oaklandrobotics/electrical_ora24/StackLight/Circuit_Diagram/IMG_8410.jpg

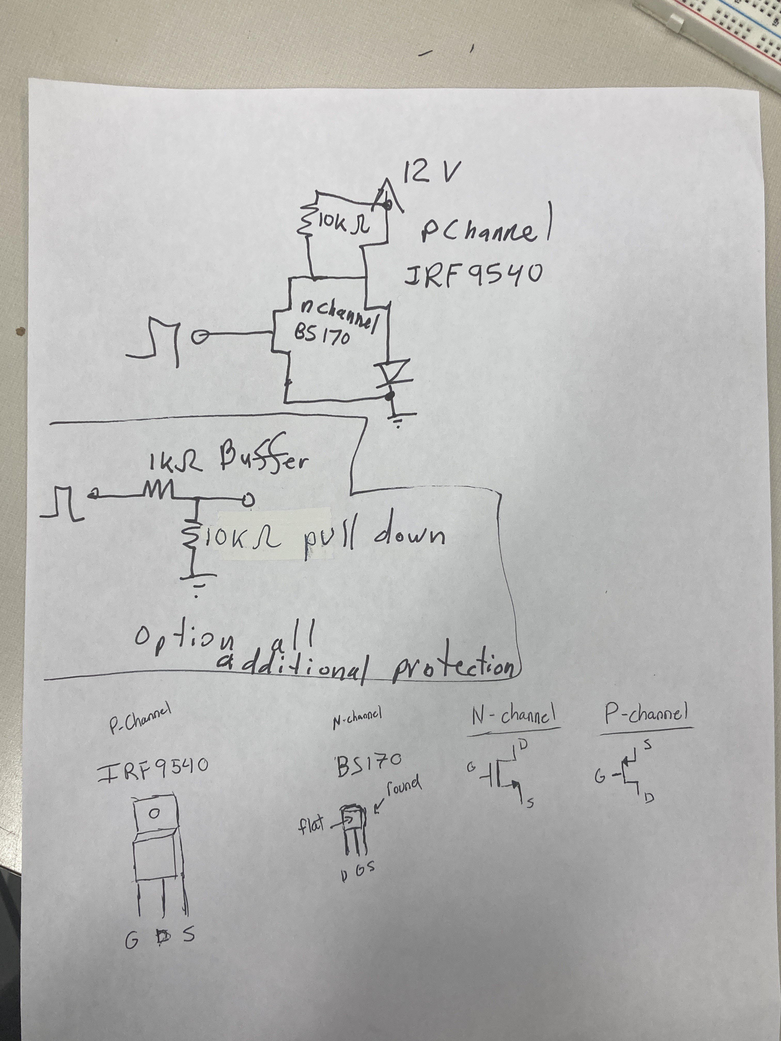
StackLight/Circuit_Diagram/IMG_8410.jpg
