oaklandrobotics/electrical_ora24/ORA_ControlBoard/ORA_ControlBoard-main_Rev_1/README.md

# ORA_ControlBoard
 Control Board for 23/24" IGVC Robot
