oaklandrobotics/electrical_ora24/ORA_ControlBoard/Original Control Board Files/ORA_Control_Board_Rev_2.1/AdditionalParts/SM04B-GHS-TB(LF)(SN)---3DModel-STEP-56544.STEP

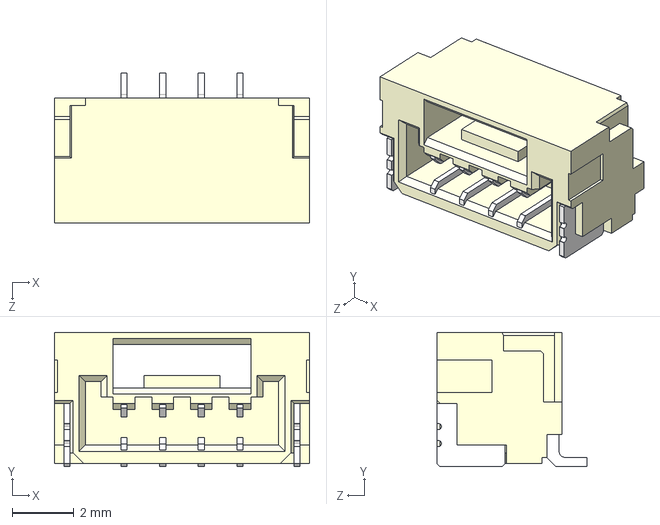
[picture p2: CAD file, 2024-03-11]
ORA_ControlBoard/Original Control Board Files/ORA_Control_Board_Rev_2.1/AdditionalParts/SM04B-GHS-TB(LF)(SN)---3DModel-STEP-56544.STEP
8.25 x 4.35 x 4.85 mm
