oaklandrobotics/electrical_ora24/ORA_ControlBoard/Original Control Board Files/ORA_Control_Board_Rev_2.1/AdditionalParts/SM04B_GHS_TB/SM04B-GHS-TB.STEP

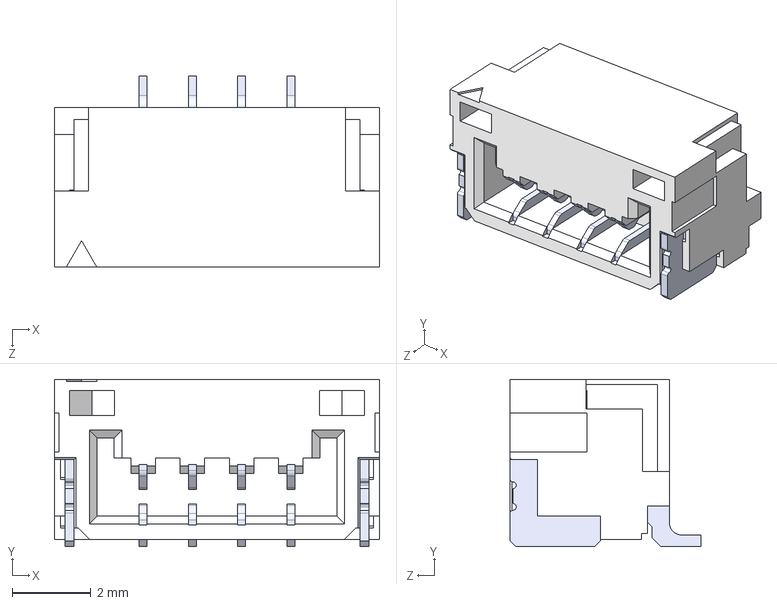
[picture p3: CAD file, 2024-03-09]
ORA_ControlBoard/Original Control Board Files/ORA_Control_Board_Rev_2.1/AdditionalParts/SM04B_GHS_TB/SM04B-GHS-TB.STEP
8.25 x 4.25 x 4.85 mm
SMxB-GHS-TB_04
pin x 4
