oaklandrobotics/electrical_ora24/StackLight/Tests/StackLight/StackLight.step

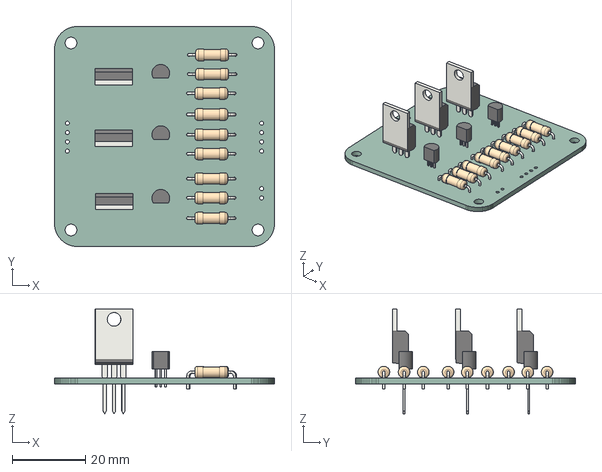
[picture p4: CAD file, 2023-11-30]
StackLight/Tests/StackLight/StackLight.step
60.0 x 60.0 x 28.5 mm
StackLight PCB
