oaklandrobotics/electrical_ora24/ORA_ControlBoard/Original Control Board Files/ORA_Control_Board_Rev_2.1/AdditionalParts/FUSE_F050-2.step

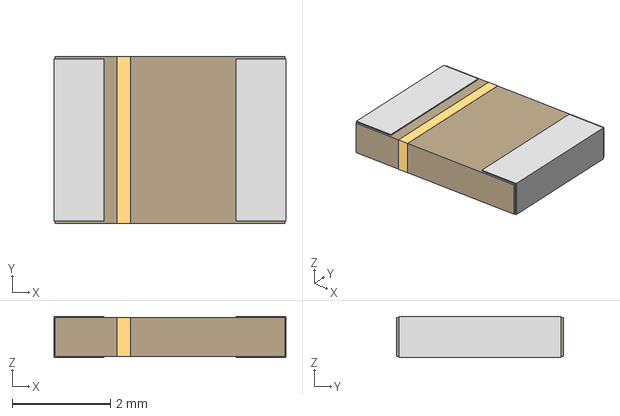
[picture p5: CAD file, 2024-03-11]
ORA_ControlBoard/Original Control Board Files/ORA_Control_Board_Rev_2.1/AdditionalParts/FUSE_F050-2.step
4.72 x 3.41 x 0.838 mm
