oaklandrobotics/electrical_ora24/ORA_ControlBoard/Original Control Board Files/ORA_Control_Board_Rev_2.1/AdditionalParts/CAP_WCAP-ASLI_05p0X05p5_WRE.step

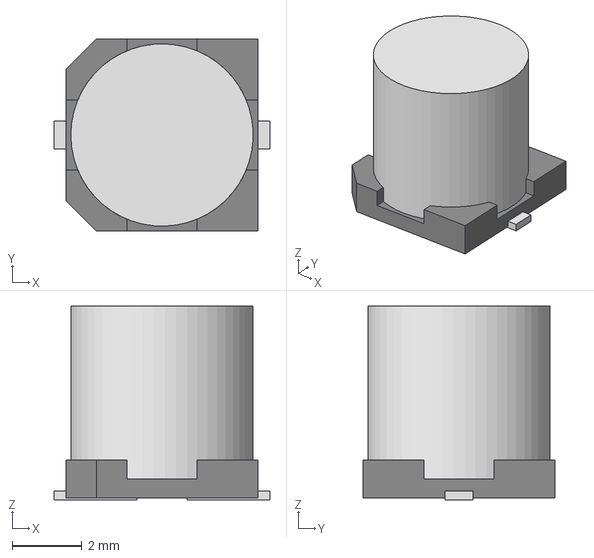
[picture p6: CAD file, 2024-03-11]
ORA_ControlBoard/Original Control Board Files/ORA_Control_Board_Rev_2.1/AdditionalParts/CAP_WCAP-ASLI_05p0X05p5_WRE.step
6.20 x 5.51 x 5.57 mm
