oaklandrobotics/electrical_ora24/ORA_ControlBoard/Original Control Board Files/ORA_Control_Board_Rev_2.1/AdditionalParts/10118192_0002LF (1)/10118192-0002LF.step

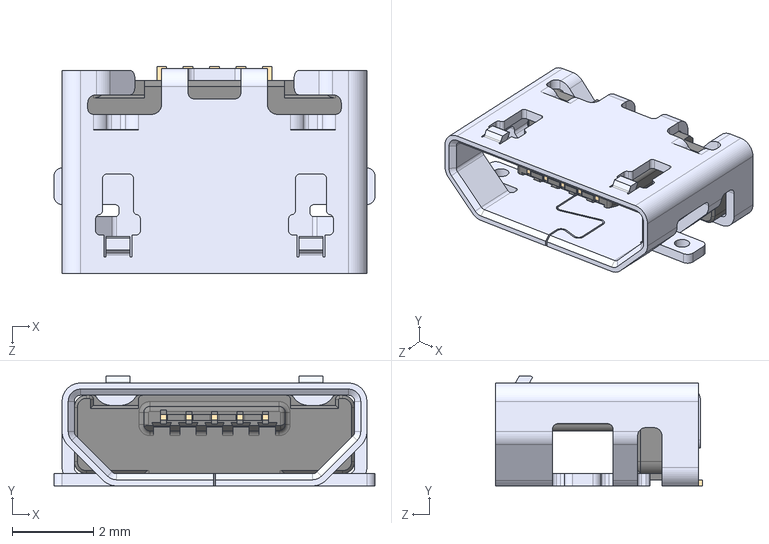
[picture p7: CAD file, 2024-03-11]
ORA_ControlBoard/Original Control Board Files/ORA_Control_Board_Rev_2.1/AdditionalParts/10118192_0002LF (1)/10118192-0002LF.step
7.90 x 2.70 x 5.10 mm
