oaklandrobotics/electrical_ora24/(threads)

Thread 2 (2023-09-26):

Fix Hindsight for possible showcase

AndrewMcGhee, 2023-09-26:
Try to fix Hindsight for the possible showcase in November. Does not need auton, just manual driver + state switching

Thread 6 (2024-05-25):

IGVC Preperations

gtrupiano, 2024-05-25:
- [ ] Add can messages for sending wheel speeds and autonomous state
- [ ] Hardware E-Stop
- [ ] Check controller disconnect fail save
- [ ] Look over Falling Edge Detection
