oaklandrobotics/electrical_ora24/ORA_ControlBoard/Original Control Board Files/ORA_Control_Board_Rev_2.1/ORA Control Board Rev2 2-18-24.pdf

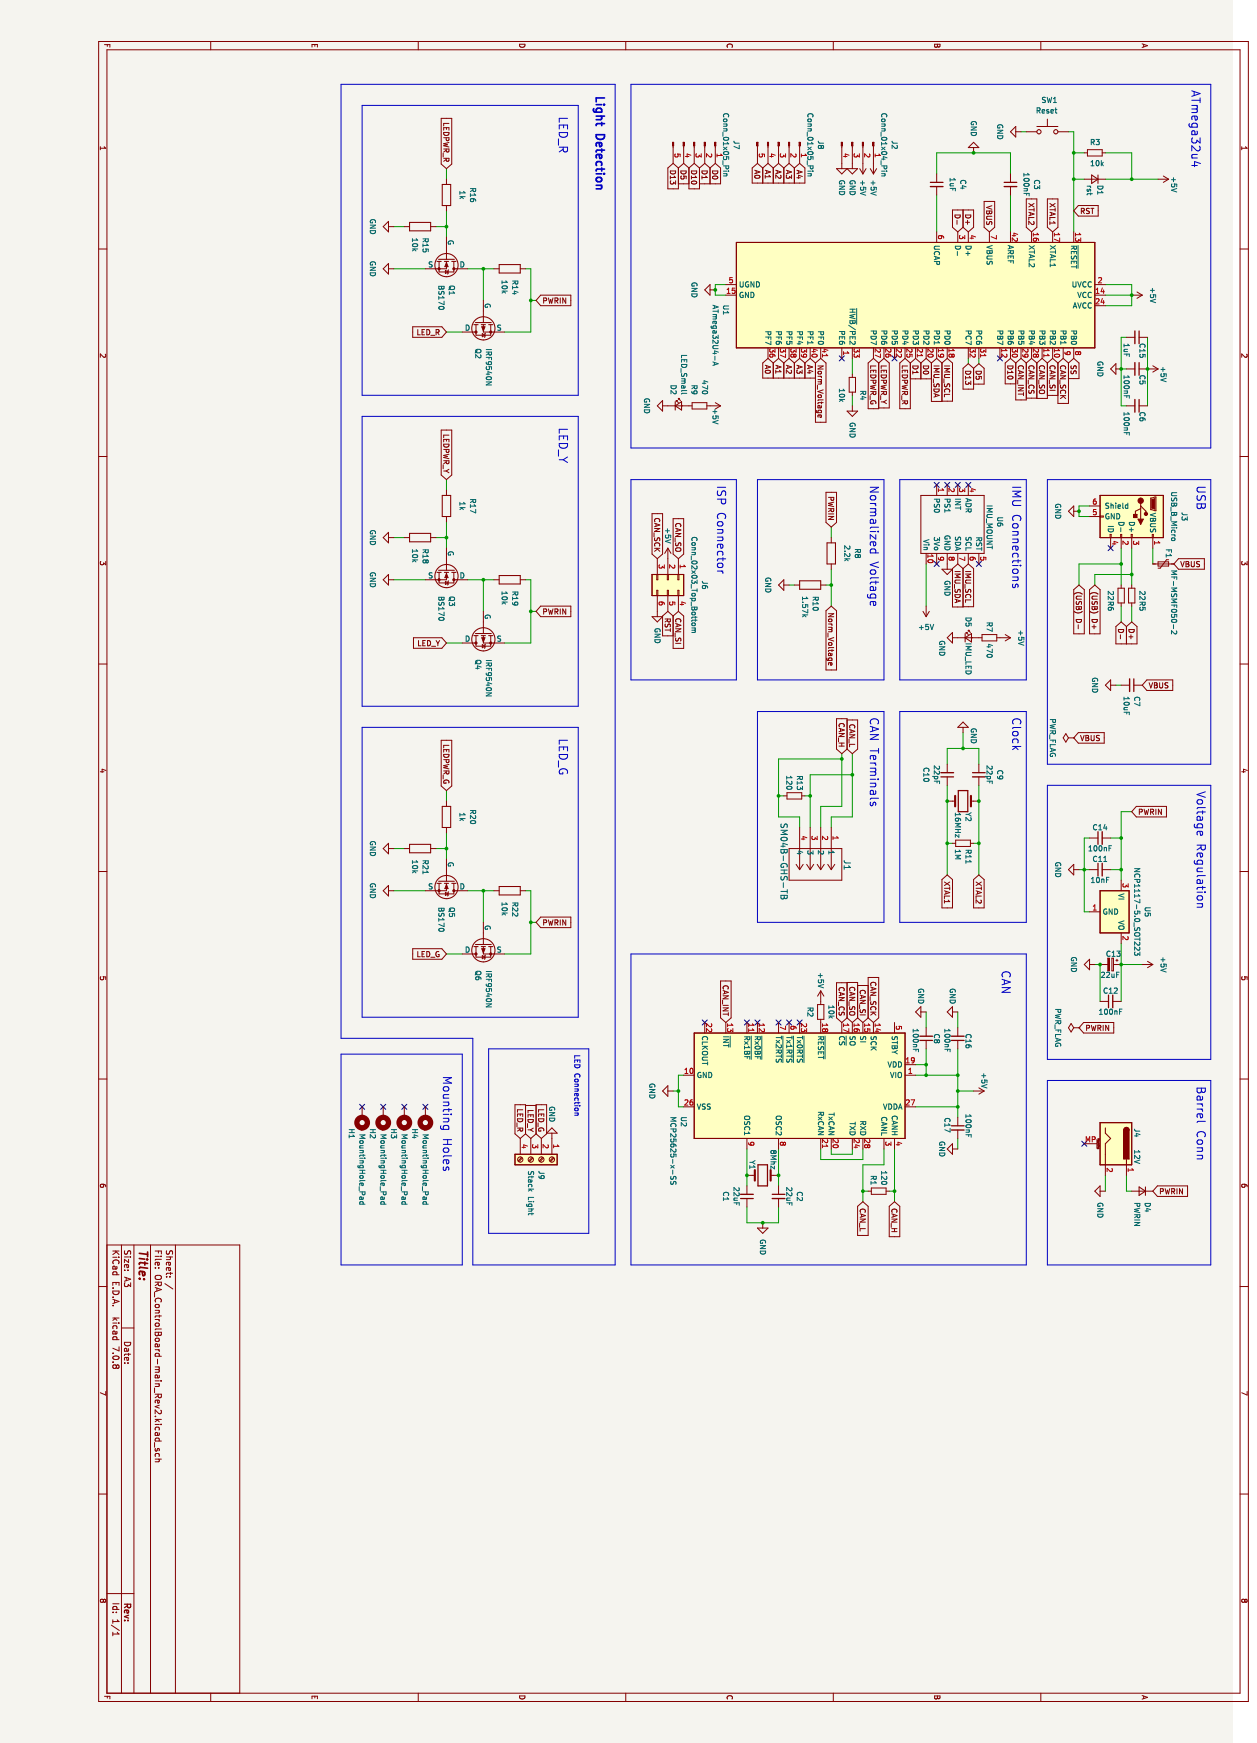
[picture p8: page 1]
