oaklandrobotics/electrical_ora24/ORA_ControlBoard/ORA_ControlBoard-main_Rev_1/Pics/Schematic 1-10-24.pdf

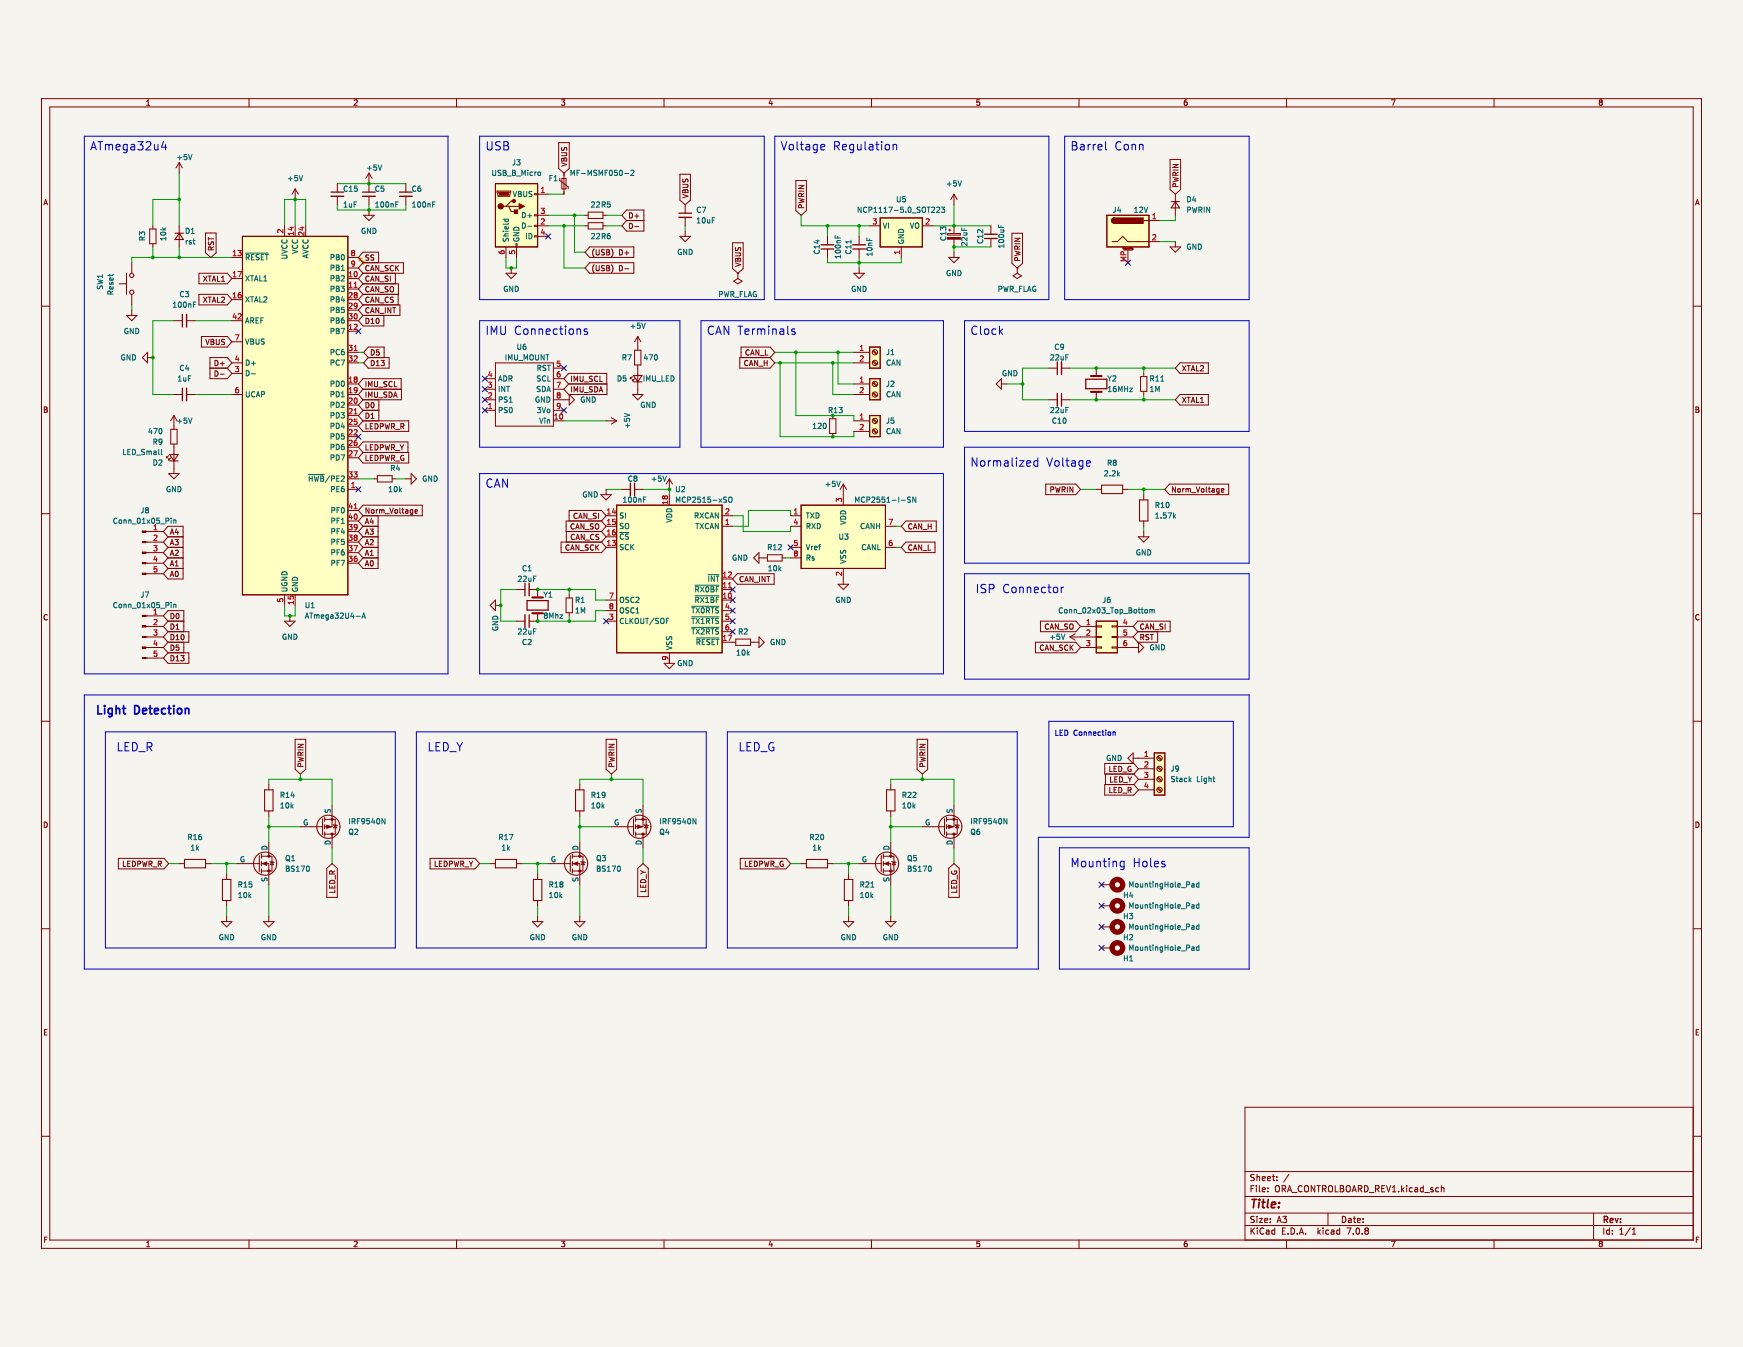
[picture p9: page 1]
