oaklandrobotics/electrical_ora24/ORA_ControlBoard/ORA_ControlBoard-main_Rev_1/Pics/PCB Layout 1-10-24.pdf

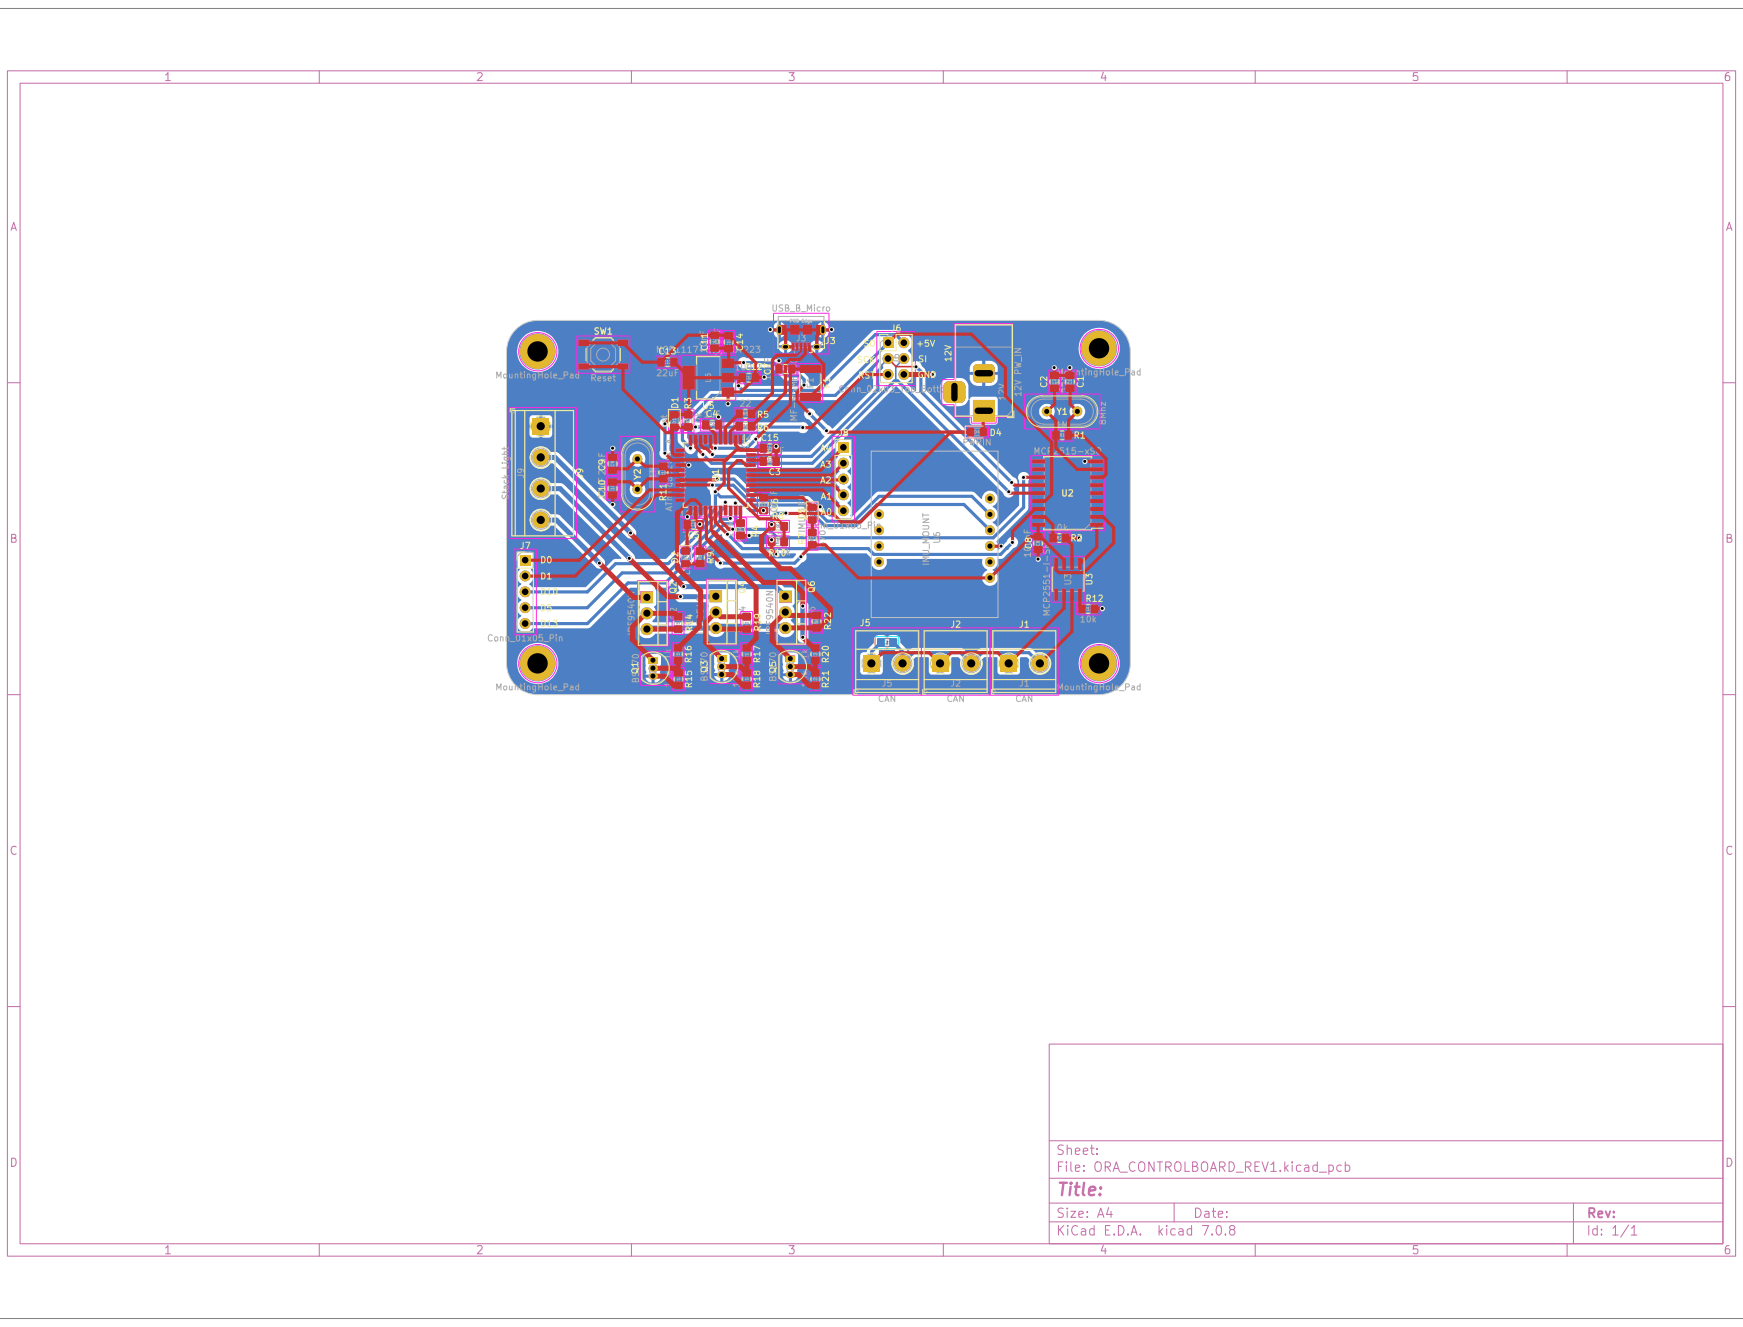
[picture p10: page 1]
