oaklandrobotics/electrical_ora24/ORA_ControlBoard/Original Control Board Files/ORA_Control_Board_Rev_2.1/ORA_Control_Board_Rev_2.1.kicad_pcb

## KiCad design ORA_ControlBoard/Original Control Board Files/ORA_Control_Board_Rev_2.1/ORA_Control_Board_Rev_2.1.kicad_pcb (2024-04-03)

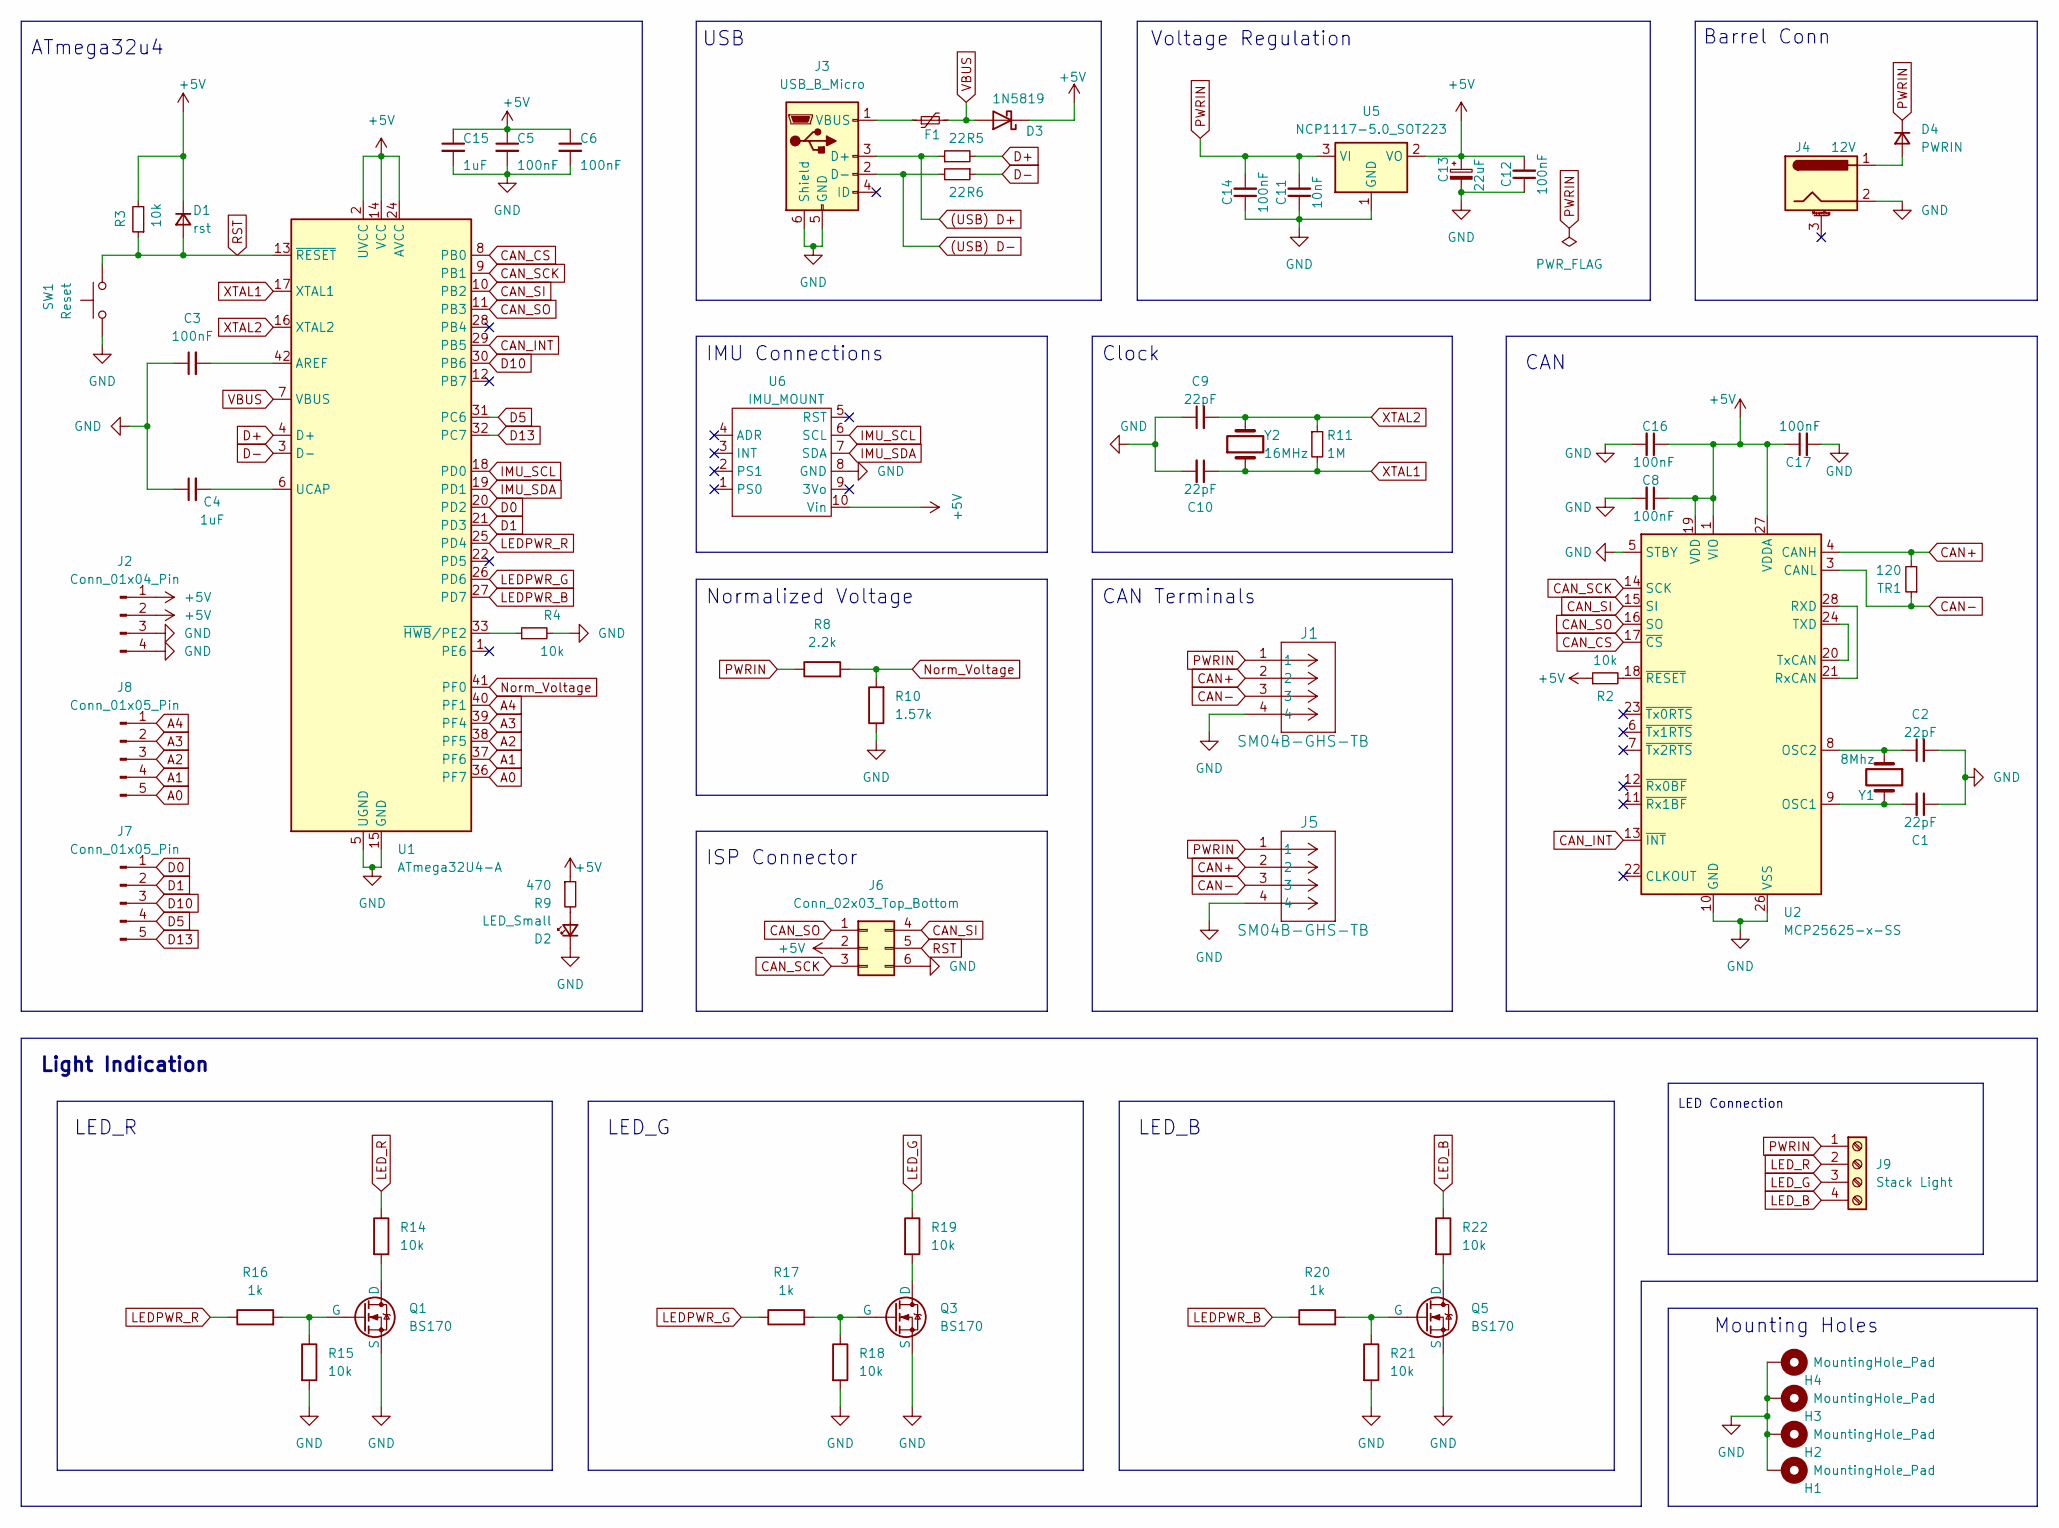
[picture p11: schematic ORA_Control_Board_Rev_2.1.kicad_sch]

Parts:
C1, C2, C9, C10: 22pF; C_0805_2012Metric_Pad1.18x1.45mm_HandSolder
C3, C5, C6, C8, C12, C14, C16, C17: 100nF; C_0805_2012Metric_Pad1.18x1.45mm_HandSolder
C4, C15: 1uF; C_0805_2012Metric_Pad1.18x1.45mm_HandSolder
C11: 10nF; C_0805_2012Metric_Pad1.18x1.45mm_HandSolder
C13: 22uF; CAP_WCAP-ASLI_05p0X05p5_WRE
D1: rst; D_SOD-323
D2: LED_Small; LED_0805_2012Metric_Pad1.15x1.40mm_HandSolder
D3: 1N5819; D_DO-41_SOD81_P10.16mm_Horizontal
D4: PWRIN; D_SOD-323
F1: MF-MSMF050-2; Fuse_1812_4532Metric_Pad1.30x3.40mm_HandSolder
H1, H2, H3, H4: MountingHole_Pad; MountingHole_3.2mm_M3_DIN965_Pad
J1, J5: SM04B-GHS-TB; CONN_SM04B-GHS-TB_JST
J2: Conn_01x04_Pin; PinHeader_1x04_P2.54mm_Vertical
J3: USB_B_Micro; AMPHENOL_10118192-0002LF
J4: 12V; BarrelJack_Horizontal
J6: Conn_02x03_Top_Bottom; PinHeader_2x03_P2.54mm_Vertical
J7, J8: Conn_01x05_Pin; PinHeader_1x05_P2.54mm_Vertical
J9: Stack Light; TerminalBlock_Phoenix_MKDS-1,5-4_1x04_P5.00mm_Horizontal
Q1, Q3, Q5: BS170; TO-92_Inline
R2, R3, R4, R14, R15, R18, R19, R21, R22: 10k; R_0805_2012Metric_Pad1.20x1.40mm_HandSolder
R5, R6: 22; R_0805_2012Metric_Pad1.20x1.40mm_HandSolder
R8: 2.2k; R_0805_2012Metric_Pad1.20x1.40mm_HandSolder
R9: 470; R_0805_2012Metric_Pad1.20x1.40mm_HandSolder
R10: 1.57k; R_0805_2012Metric_Pad1.20x1.40mm_HandSolder
R11: 1M; R_0805_2012Metric_Pad1.20x1.40mm_HandSolder
R16, R17, R20: 1k; R_0805_2012Metric_Pad1.20x1.40mm_HandSolder
SW1: Reset; SW_SPST_TL3342
TR1: 120; R_0805_2012Metric_Pad1.20x1.40mm_HandSolder
U1: ATmega32U4-A; TQFP-44_10x10mm_P0.8mm
U2: MCP25625-x-SS; SSOP-28_5.3x10.2mm_P0.65mm
U5: NCP1117-5.0_SOT223; SOT-223-3_TabPin2
U6: IMU_MOUNT
Y1: 8Mhz; Crystal_HC49-4H_Vertical
Y2: 16MHz; Crystal_HC49-4H_Vertical

Connections:
(USB) D+: J3.3 (D+), R5.1
(USB) D-: J3.2 (D-), R6.2
+5V: C5.1, C6.1, C8.1, C12.2, C13.1, C15.1, C16.1, C17.1, D1.1 (K), D3.1 (K), J2.1, J2.2, J6.2, R2.1, R3.2, R9.1, U1.2 (UVCC), U1.14 (VCC), U1.24 (AVCC), U1.34 (VCC), U1.44 (AVCC), U2.1 (VIO), U2.19 (VDD), U2.27 (VDDA), U5.2 (VO), U6.10 (Vin)
A0: J8.5, U1.36 (PF7)
A1: J8.4, U1.37 (PF6)
A2: J8.3, U1.38 (PF5)
A3: J8.2, U1.39 (PF4)
A4: J8.1, U1.40 (PF1)
CAN+: J1.2, J5.2, TR1.2, U2.4 (CANH)
CAN-: J1.3, J5.3, TR1.1, U2.3 (CANL)
CAN_CS: U1.8 (PB0), U2.17 (~CS)
CAN_INT: U1.29 (PB5), U2.13 (~INT)
CAN_SCK: J6.3, U1.9 (PB1), U2.14 (SCK)
CAN_SI: J6.4, U1.10 (PB2), U2.15 (SI)
CAN_SO: J6.1, U1.11 (PB3), U2.16 (SO)
D0: J7.1, U1.20 (PD2)
D1: J7.2, U1.21 (PD3)
D5: J7.4, U1.31 (PC6)
D10: J7.3, U1.30 (PB6)
D13: J7.5, U1.32 (PC7)
D+: R5.2, U1.4 (D+)
D-: R6.1, U1.3 (D-)
GND: C1.1, C2.2, C3.1, C4.1, C5.2, C6.2, C8.2, C9.1, C10.2, C11.1, C12.1, C13.2, C14.1, C15.2, C16.2, C17.2, D2.1 (K), H1.1, H2.1, H3.1, H4.1, J1.4, J2.3, J2.4, J3.5 (GND), J3.6 (Shield), J4.2, J5.4, J6.6, Q1.3 (S), Q3.3 (S), Q5.3 (S), R4.2, R10.1, R15.2, R18.2, R21.2, SW1.1, U1.5 (UGND), U1.15 (GND), U1.23 (GND), U1.35 (GND), U1.43 (GND), U2.5 (STBY), U2.10 (GND), U2.26 (VSS), U5.1 (GND), U6.8 (GND)
IMU_SCL: U1.18 (PD0), U6.6 (SCL)
IMU_SDA: U1.19 (PD1), U6.7 (SDA)
LEDPWR_B: R20.1, U1.27 (PD7)
LEDPWR_G: R17.1, U1.26 (PD6)
LEDPWR_R: R16.1, U1.25 (PD4)
LED_B: J9.4, R22.1
LED_G: J9.3, R19.1
LED_R: J9.2, R14.1
unnamed: D2.2 (A), R9.2
unnamed: D4.2 (A), J4.1
unnamed: F1.1, J3.1 (VBUS)
unnamed: Q1.1 (D), R14.2
unnamed: Q1.2 (G), R15.1, R16.2
unnamed: Q3.1 (D), R19.2
unnamed: Q3.2 (G), R17.2, R18.1
unnamed: Q5.1 (D), R22.2
unnamed: Q5.2 (G), R20.2, R21.1
unnamed: C3.2, U1.42 (AREF)
unnamed: C4.2, U1.6 (UCAP)
unnamed: R4.1, U1.33 (~HWB/PE2)
unnamed 43: C1.2, U2.9 (OSC1), Y1.2; also elsewhere on the board
unnamed 44: C2.1, U2.8 (OSC2), Y1.1; also elsewhere on the board
unnamed: U2.21 (RxCAN), U2.28 (RXD)
unnamed: U2.20 (TxCAN), U2.24 (TXD)
unnamed: R2.2, U2.18 (~RESET)
Norm_Voltage: R8.2, R10.2, U1.41 (PF0)
PWRIN: C11.2, C14.2, D4.1 (K), J1.1, J5.1, J9.1, R8.1, U5.3 (VI)
RST: D1.2 (A), J6.5, R3.1, SW1.2, U1.13 (~RESET)
VBUS: D3.2 (A), F1.2, U1.7 (VBUS)
XTAL1: C10.1, R11.2, U1.17 (XTAL1), Y2.1
XTAL2: C9.2, R11.1, U1.16 (XTAL2), Y2.2

Notes on the sheet:
Mounting Holes
Voltage Regulation
CAN
CAN Terminals
USB
Light Indication
Barrel Conn
LED_R
Normalized Voltage
ISP Connector
IMU Connections
Clock
LED Connection
LED_B
LED_G
ATmega32u4

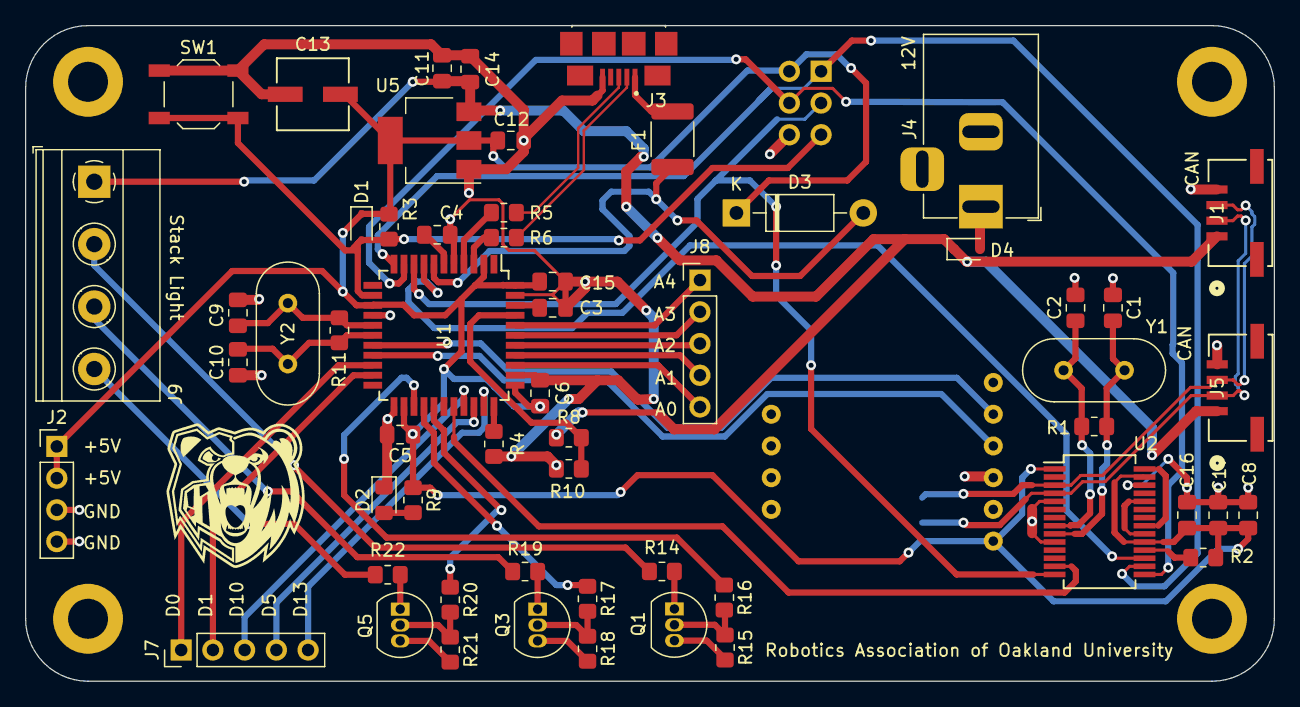
[picture p12: board ORA_Control_Board_Rev_2.1.kicad_pcb from above]

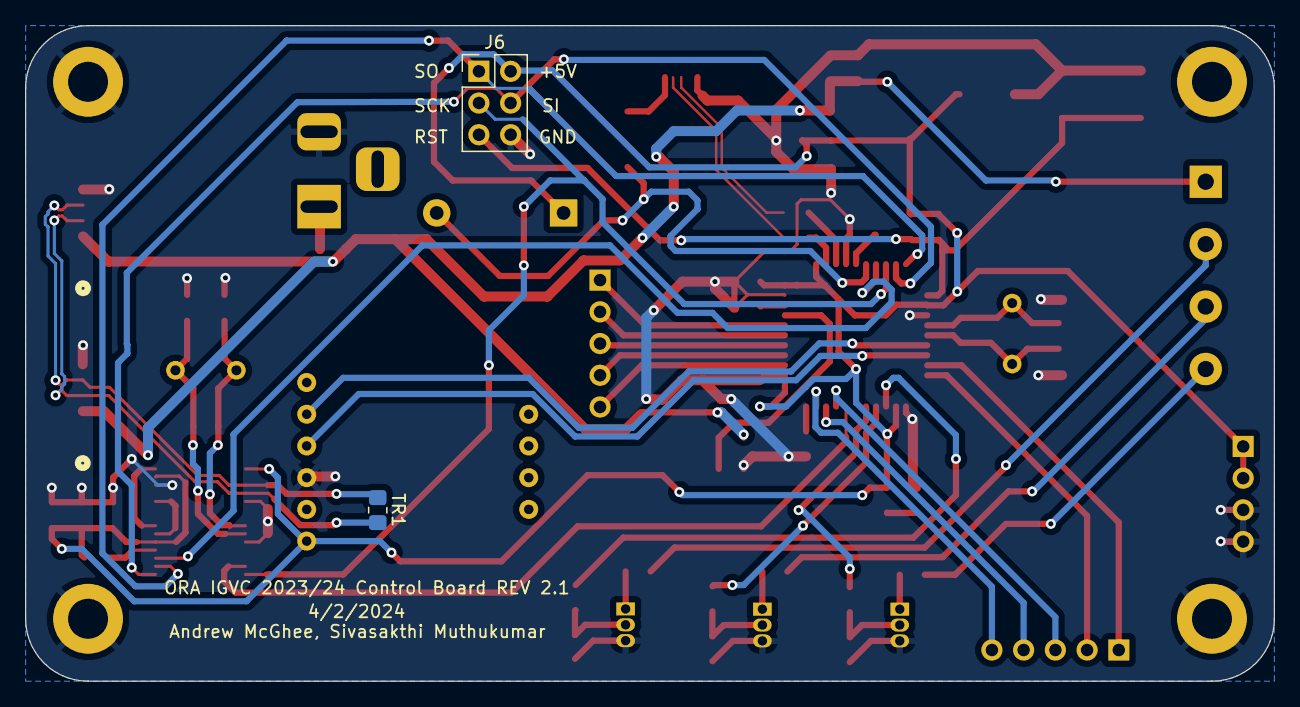
[picture p13: board ORA_Control_Board_Rev_2.1.kicad_pcb from below]

Board: 2 copper layers, 100.0 x 52.5 mm, 64 parts (2 on the bottom side), 54 nets.

Other parts of the board:
R1: 1M; R_0805_2012Metric_Pad1.20x1.40mm_HandSolder

Their connections:
unnamed 43: R1.2; also elsewhere on the board
unnamed 44: R1.1; also elsewhere on the board
