oaklandrobotics/electrical_ora24/StackLight/Tests/StackLight/StackLight.kicad_pcb

## KiCad design StackLight/Tests/StackLight/StackLight.kicad_pcb (2023-11-30)

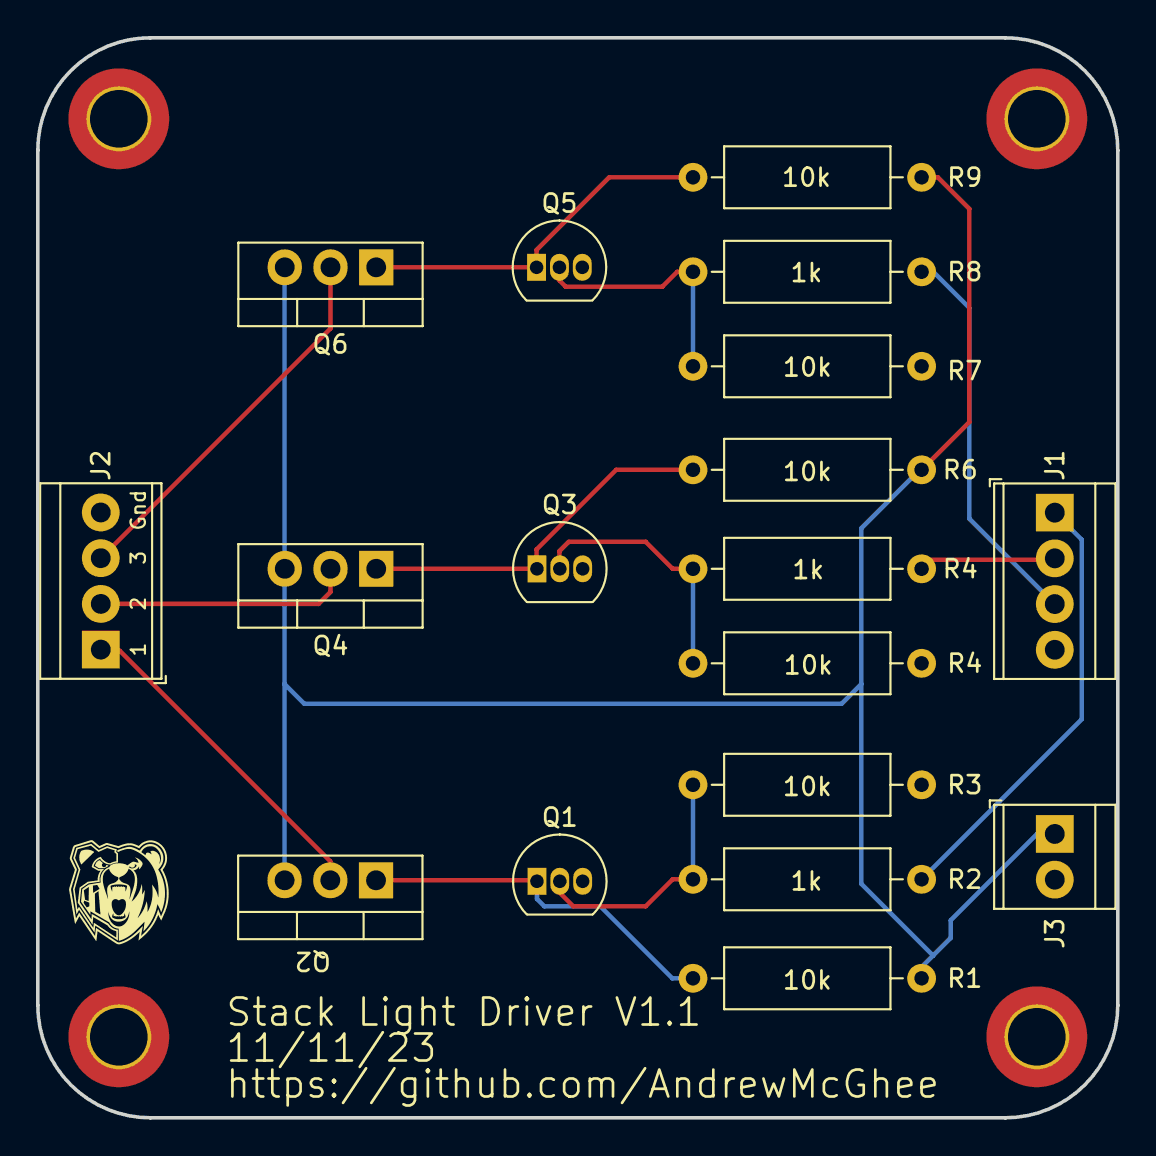
[picture p14: board StackLight.kicad_pcb from above]

Board: 2 copper layers, 60.0 x 60.0 mm, 23 parts (0 on the bottom side), 14 nets.

Parts:
G1: LOGO; ORA_Logo
H1, H2, H3, H4: MountingHole; MountingHole_3.2mm_M3_DIN965_Pad_TopOnly
J1: ARDUINO_INPUT; TerminalBlock_TE_282834-4_1x04_P2.54mm_Horizontal
J2: LED_OUTPUT; TerminalBlock_TE_282834-4_1x04_P2.54mm_Horizontal
J3: Conn_01x02; TerminalBlock_TE_282834-2_1x02_P2.54mm_Horizontal
Q1, Q3, Q5: BS170; TO-92_Inline
Q2, Q4, Q6: IRF9540N; TO-220-3_Vertical
R1, R3, R4, R6, R7, R9: 10k; R_Axial_DIN0309_L9.0mm_D3.2mm_P12.70mm_Horizontal
R2, R5, R8: 1k; R_Axial_DIN0309_L9.0mm_D3.2mm_P12.70mm_Horizontal

Connections:
+12V: J3.1, Q2.3 (S), Q4.3 (S), Q6.3 (S), R1.1, R6.1, R9.1
ARD_1: J1.1, R2.1
ARD_2: J1.2, R5.1
ARD_3: J1.3, R8.1
LED_1: J2.1, Q2.2 (D)
LED_2: J2.2, Q4.2 (D)
LED_3: J2.3, Q6.2 (D)
LED_GND: H1.1, H2.1, H3.1, H4.1, J1.4, J2.4, J3.2, Q1.3 (S), Q3.3 (S), Q5.3 (S), R3.1, R4.1, R7.1
unnamed: Q1.1 (D), Q2.1 (G), R1.2
unnamed: Q1.2 (G), R2.2, R3.2
unnamed: Q3.1 (D), Q4.1 (G), R6.2
unnamed: Q3.2 (G), R4.2, R5.2
unnamed: Q5.1 (D), Q6.1 (G), R9.2
unnamed: Q5.2 (G), R7.2, R8.2
