oaklandrobotics/electrical_ora24/StackLight/Code/Controlled_Testing/Controlled_Testing.ino

const int ledPin1 = 2;
const int ledPin2 = 3;
const int ledPin3 = 4;

void setup() {
  // put your setup code here, to run once:
  pinMode(ledPin1, OUTPUT);
  pinMode(ledPin2, OUTPUT);
  pinMode(ledPin3, OUTPUT);
}

void loop() {
  // put your main code here, to run repeatedly:
  
}
