oaklandrobotics/electrical_ora24/StackLight/Code/LED_Testing/LED_Testing.ino

const int ledPin1 = 2;
const int ledPin2 = 3;
const int ledPin3 = 4;

void setup() {
  pinMode(ledPin1, OUTPUT);
  pinMode(ledPin2, OUTPUT);
  pinMode(ledPin3, OUTPUT);
}

void loop() {
  digitalWrite(ledPin1, HIGH);
  delay(1000);
  digitalWrite(ledPin1, LOW);
  delay(500);
  
  digitalWrite(ledPin2, HIGH);
  delay(1000);
  digitalWrite(ledPin2, LOW);
  delay(500);
  
  digitalWrite(ledPin3, HIGH);
  delay(1000);
  digitalWrite(ledPin3, LOW);
  delay(500);
}
