oaklandrobotics/electrical_ora24/(commit log)

2023-09-26 Created file for ODrive Testing
2023-09-27 Created Arduino for testing
2023-11-04 Implement basic ODrive connection code
    Taken from the example code provided by ODrive, currently moves the motor in a jerky sine wave.
2023-11-11 Change to setting velocity targets from computer
    Inputting negative numbers should set the target velocity to 0, only positive numbers inputs affect the target velocity
2023-11-26 Moved Stacklight
    [LEDControlCircuit.kicad_sch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]
2024-03-01 Updated
    Todo:
    Check pin PB0 connection on board
2024-03-01 Added Board Files
    Added the raw board files outside of a zip so they could be opened in KiCAD and updated accordingly without needing to send a zip file back and forth
    [CAN_Circuit.kicad_sch, IMUCONN_sch.kicad_sch, ORA_CONTROLBOARD_REV1.csv, ORA_CONTROLBOARD_REV1.kicad_pcb, ORA_CONTROLBOARD_REV1.kicad_sch]
2024-03-09 Uploaded Rev 2
    [IMUCONN_sch.kicad_sch, ORA_ControlBoard-main_Rev2.csv, ORA_ControlBoard-main_Rev2.kicad_pcb, ORA_ControlBoard-main_Rev2.kicad_sch, ORA_ControlBoard-main_Rev2.xlsx, SM04B-GHS-TB.STEP]
2024-03-10 Spring Cleaning
    [CAN_Circuit.kicad_sch, IMUCONN_sch.kicad_sch, ORA_CONTROLBOARD_REV1.csv, ORA_CONTROLBOARD_REV1.kicad_pcb, ORA_CONTROLBOARD_REV1.kicad_sch, ORA_CONTROLBOARD_REV1.xlsx]
2024-03-10 Updated LED circuit
    [ORA_ControlBoard-main_Rev2.kicad_sch]
2024-03-10 Fixed Spring Cleaning
    [CAN_Circuit.kicad_sch, IMUCONN_sch.kicad_sch, ORA_CONTROLBOARD_REV1.csv, ORA_CONTROLBOARD_REV1.kicad_pcb, ORA_CONTROLBOARD_REV1.kicad_sch, ORA_CONTROLBOARD_REV1.xlsx, ORA_ControlBoard-main_Rev2.kicad_pcb, ORA_ControlBoard-main_Rev2.kicad_sch]
2024-03-11 Updated USB B micro footprint
2024-03-11 Grounded mounting holes, labelled terminating resistors
2024-03-11 Moved ISP pins to back of board
2024-03-11 le testing
    [ORA_ControlBoard-main_Rev2.kicad_pcb]
2024-03-11 "Final" Rev 2 changes
    [10118192-0002LF.step, CAP_WCAP-ASLI_05p0X05p5_WRE.step, FUSE_F050-2.step, ORA_ControlBoard-main_Rev2.kicad_pcb, ORA_ControlBoard-main_Rev2.kicad_sch, SM04B-GHS-TB(LF)(SN)---3DModel-STEP-56544.STEP]
2024-03-12 I generated a gerber :/
    [ORA_ControlBoard-main_Rev2-B_Cu.gbr, ORA_ControlBoard-main_Rev2-B_Mask.gbr, ORA_ControlBoard-main_Rev2-B_Paste.gbr, ORA_ControlBoard-main_Rev2-B_Silkscreen.gbr, ORA_ControlBoard-main_Rev2-Edge_Cuts.gbr, ORA_ControlBoard-main_Rev2-F_Cu.gbr, ORA_ControlBoard-main_Rev2-F_Mask.gbr, ORA_ControlBoard-main_Rev2-F_Paste.gbr]
2024-03-30 Control board program and ESP program completed.
    Still need to test sending CAN signals to ODrive
2024-04-01 Revision
    Things changed:
    VBUS flag added in between fuse and schottky diode (check this)
    Got rid of C7 and GND to VBUS pin on ATmega
    Changed silkscreen for ISP pins
    [ORA_ControlBoard-main_Rev2.kicad_pcb, ORA_ControlBoard-main_Rev2.kicad_sch]
2024-04-03 Rev 2.1
    VBUS flag added in between fuse and schottky diode
    Make CAN_H and CAN_L traces differential pairs
    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
    [ORA_ControlBoard-main_Rev2.kicad_pcb, ORA_ControlBoard-main_Rev2.kicad_sch]
2024-04-17 I fixed a name lol
    Oops
    [StackLight_Test_v1.ino]
2024-04-19 Added ESP32 Program and Reorganized program that work
2024-04-21 Added original control board files for rev 2
    They are put in different folder to make sure nothing is messed up hopefully.
    [10118192-0002LF.step, CAN_Circuit.kicad_sch, CAP_WCAP-ASLI_05p0X05p5_WRE.step, FUSE_F050-2.step, IMUCONN_sch.kicad_sch, ORA_Control_Board_Rev_1.csv, ORA_Control_Board_Rev_1.kicad_pcb, ORA_Control_Board_Rev_1.kicad_sch]
2024-06-01 Updated Arduino and ESP Program
    Logic for differential drive is still not working properly
    [Robot_Base_Arduino.ino, Robot_ESP32_Controller.ino]
